fablabnk/HagiwoHatNoise_THT/README.md

# HagiwoHatNoise

# Notes

5v from Arduino or directly from 5V rail?
Patch submodule uses 22uF ceramic decoupling cap instead of 10uF electrolytic

# ToDo

- move decoupling caps close to Arduino on layout (both?!)
