fablabnk/HagiwoHatNoise_THT/HagiwoHatNoise.kicad_pcb

## KiCad design HagiwoHatNoise.kicad_pcb (2024-09-25)

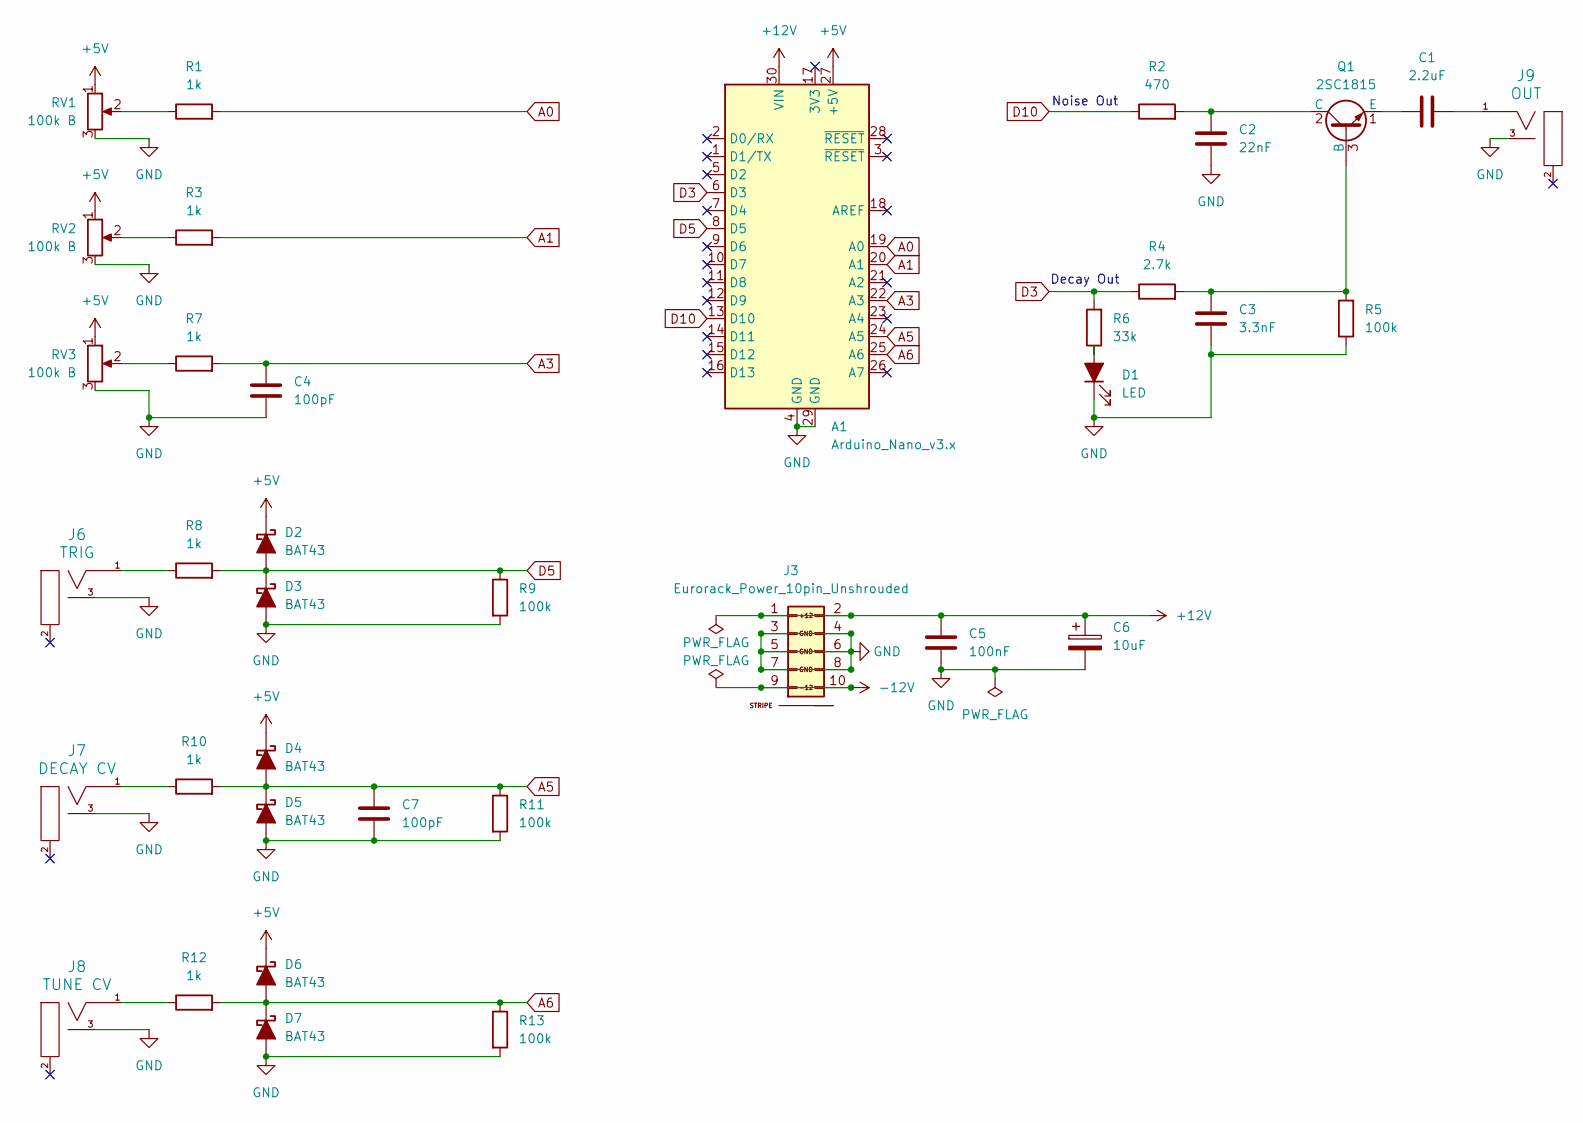
[picture p1: schematic HagiwoHatNoise.kicad_sch]

Parts:
A1: Arduino_Nano_v3.x; Arduino_Nano
C1: 2.2uF; C_Disc_D3.8mm_W2.6mm_P2.50mm
C2: 22nF; C_Disc_D3.8mm_W2.6mm_P2.50mm
C3: 3.3nF; C_Disc_D3.8mm_W2.6mm_P2.50mm
C4, C7: 100pF; C_Disc_D3.8mm_W2.6mm_P2.50mm
C5: 100nF; C_Disc_D3.8mm_W2.6mm_P2.50mm
C6: 10uF; CP_Radial_D4.0mm_P2.00mm
D1: LED; LED_D5.0mm
D2, D3, D4, D5, D6, D7: BAT43; D_DO-35_SOD27_P7.62mm_Horizontal_Widened_No_K
J3: Eurorack_Power_10pin_Unshrouded; IDC-Header_2x05_P2.54mm_Vertical_Euro_Power_Striped_Thicker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; Part Number 1-1002FBV0T
J6: TRIG; EighthInch_PJ398SM_3mmNPTH; Part Number WQP-WQP518MA
J7: DECAY CV; EighthInch_PJ398SM_3mmNPTH; Part Number WQP-WQP518MA
J8: TUNE CV; EighthInch_PJ398SM_3mmNPTH; Part Number WQP-WQP518MA
J9: OUT; EighthInch_PJ398SM_3mmNPTH; Part Number WQP-WQP518MA
Q1: 2SC1815; TO-92L_Inline_Wide
R1, R3, R7, R8, R10, R12: 1k; R_Axial_DIN0207_L6.3mm_D2.5mm_P7.62mm_Horizontal
R2: 470; R_Axial_DIN0207_L6.3mm_D2.5mm_P7.62mm_Horizontal
R4: 2.7k; R_Axial_DIN0207_L6.3mm_D2.5mm_P7.62mm_Horizontal
R5, R9, R11, R13: 100k; R_Axial_DIN0207_L6.3mm_D2.5mm_P7.62mm_Horizontal
R6: 33k; R_Axial_DIN0207_L6.3mm_D2.5mm_P7.62mm_Horizontal
RV1, RV2, RV3: 100k B; Pot_9mm_DShaft_RemovedPins4_5

Connections:
+5V: A1.27 (+5V), D2.1 (K), D4.1 (K), D6.1 (K), RV1.1, RV2.1, RV3.1
+12V: A1.30 (VIN), C5.1, C6.1, J3.1 (+12V), J3.2 (+12V)
-12V: J3.9 (-12V), J3.10 (-12V)
A0: A1.19 (A0), R1.2
A1: A1.20 (A1), R3.2
A3: A1.22 (A3), C4.1, R7.2
A5: A1.24 (A5), C7.1, D4.2 (A), D5.1 (K), R10.2, R11.1
A6: A1.25 (A6), D6.2 (A), D7.1 (K), R12.2, R13.1
D3: A1.6 (D3), R4.1, R6.2
D5: A1.8 (D5), D2.2 (A), D3.1 (K), R8.2, R9.1
D10: A1.13 (D10), R2.1
GND: A1.4 (GND), A1.29 (GND), C2.2, C3.2, C4.2, C5.2, C6.2, C7.2, D1.1 (K), D3.2 (A), D5.2 (A), D7.2 (A), J3.3 (GND), J3.4 (GND), J3.5 (GND), J3.6 (GND), J3.7 (GND), J3.8 (GND), J6.3 (SW), J7.3 (SW), J8.3 (SW), J9.3 (SW), R5.1, R9.2, R11.2, R13.2, RV1.3, RV2.3, RV3.3
unnamed: D1.2 (A), R6.1
unnamed: J6.1 (SIG), R8.1
unnamed: J7.1 (SIG), R10.1
unnamed: J8.1 (SIG), R12.1
unnamed: C1.2, J9.1 (SIG)
unnamed: C3.1, Q1.3 (B), R4.2, R5.2
unnamed: C2.1, Q1.2 (C), R2.2
unnamed: C1.1, Q1.1 (E)
unnamed: R1.1, RV1.2
unnamed: R3.1, RV2.2
unnamed: R7.1, RV3.2

Notes on the sheet:
Noise Out
Decay Out

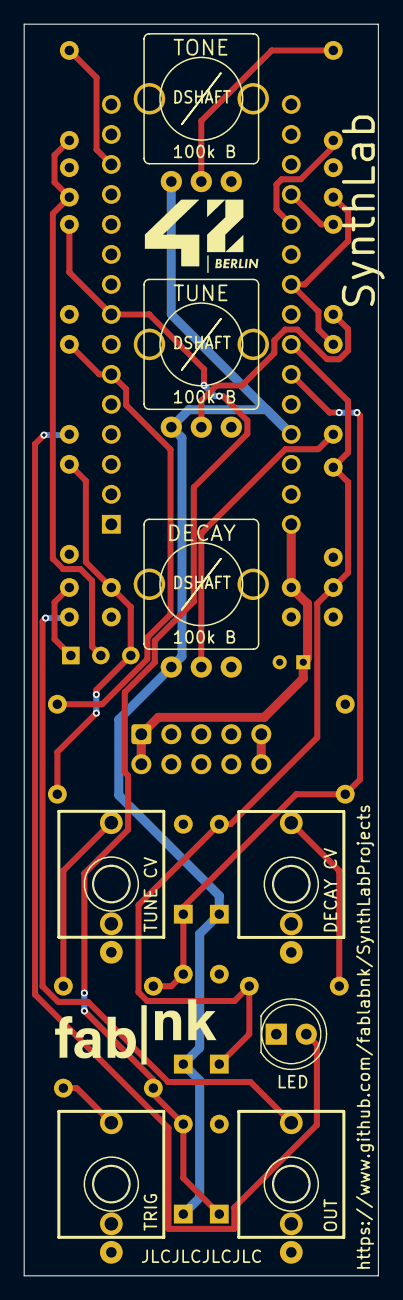
[picture p2: board HagiwoHatNoise.kicad_pcb from above]

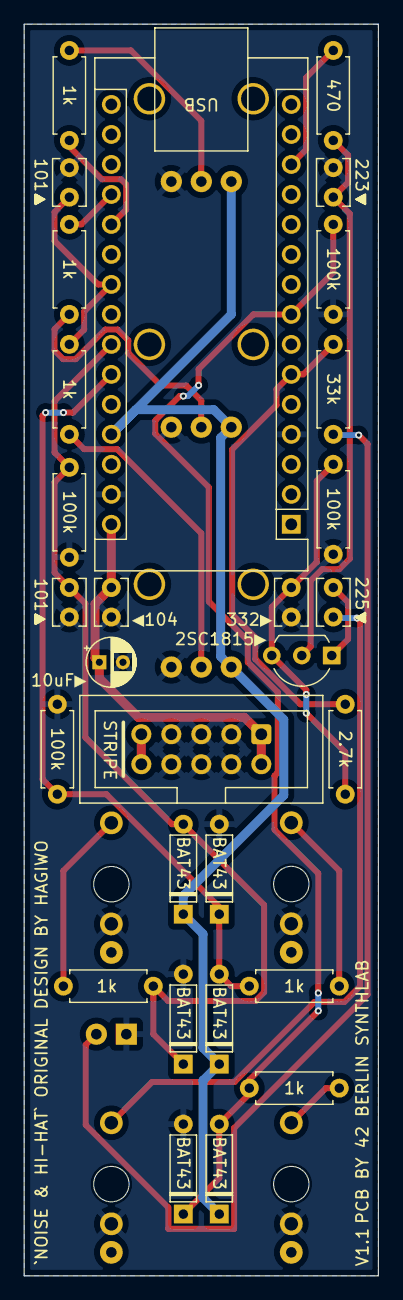
[picture p3: board HagiwoHatNoise.kicad_pcb from below]

Board: 2 copper layers, 30.0 x 106.0 mm, 37 parts (29 on the bottom side), 23 nets.
