fablabnk/HagiwoHatNoise_THT/BuildNotes.md

# V1.0

## Things to pay attention to whilst building

## Design issues to fix in V1.1

- DONE: 30 mil for power traces
- DONE: 20 mil for signal traces
- FIXED: power header silkscreen is on wrong side of board
- FIXED: use wider footprint for transistor
- FIXED: pots should be marked as linear (i.e. add B on silkscreening)
- panel is missing LED hole

## Component issues
