fablabnk/HagiwoHatNoise_THT/(commit log)

2024-08-11 v1.0 ready for production
    [HagiwoHatNoise.kicad_pcb, HagiwoHatNoise.kicad_sch, HagiwoHatNoise_Panel.kicad_pcb, bom-old.csv, bom.csv, designators.csv, positions.csv]
2024-08-13 latest updates
    [HagiwoHatNoise.kicad_sch]
2024-09-15 added BuildNotes.md. Removed production folder
    [HagiwoHatNoise.kicad_pcb, bom.csv, designators.csv, positions.csv]
2024-09-22 v1.1 ready for final check
    [HagiwoHatNoise.kicad_pcb, HagiwoHatNoise.kicad_sch, HagiwoHatNoise_Panel.kicad_pcb]
2024-09-25 v1.1 checked
    [HagiwoHatNoise.kicad_pcb]
2024-12-01 updating after Dmitri's changes
    [HagiwoHatNoise.kicad_pcb, HagiwoHatNoise.kicad_sch, HagiwoHatNoise_Panel.kicad_pcb, HagiwoHatNoise_THT.csv, bom-old.csv]
2024-12-14 added modified version of code which inverts pots to correct for miswiring of pins 1 and 3
    [HagiwoHatNoise.ino]
